ImOutis1669/Line-Following-Robot/docs/Customer_System Requirements.docx

8. Multifunctional Robot

Robotics involving design, construction, and operation of robots become more and more popular in multiple areas our life. The aim of robotics is to design machines that can assist humans. Remote control robots, robots with multiple sensors, a line following robot (use infrared sensors to follow a white line on a black surface or black line on a white surface), and many more can be implemented.

The client would like to develop multifunctional robot controlled by separately developed remote control pilot or use sensor arrays to follow the line. The pilot would use Bluetooth module and be operated by joystick. In case of line-following operation, optical sensors array needs to be integrated and capable of detecting the robot's position with respect to the line (line following robot); complete a lap of an oval line following course at Aston University.

Preferable base for this project would be DFRobot Robotics Kits - ROB0154;

https://www.mouser.co.uk/ProductDetail/DFRobot/ROB0154?qs=17u8i%2FzlE8%2FnIAY%252BNmGxXA%3D%3D

Mouser No:426-ROB0154 (final choice of this component needs to be discussed at ordering stage)

CR-101 – To develop a multifunctional robot capable of operating in 2 modes

- Line following (white or black line)
- Remote control

CR-102 – Use an optical sensor array to determine its position relative to a line and follow it

CR-103 – Capable of completing a lap non-stop of an oval track in line following mode

CR-104 – A separately developed remote control using a joystick and Bluetooth for wireless communication

CR-105 – Preferably use the DFRobot Robotics Kits - ROB0154 as a base

CR-106 – The system should be safe, reliable and easy to control for demonstration purposes

SR-201 – Use an array of infrared sensors for determining position relative to the line (CR-102)

SR 202 – Integrate a Bluetooth module for wireless communication in remote control (CR-104)

SR-203 – Use a joystick input for remote control (CR-104)

SR-204 – Use a base of the DFRobot Robotics Kits - ROB0154 (CR-105)

SR-205 – Include an emergency stop using a sensor to completely stop the vehicle (CR-106)

SR-206 – Maintain line following for a complete lap of an oval test track (CR-103/CR-106)

SR-207 – Provide a mode selection interface – a switch to change between remote-control and line following (CR-101)
