ImOutis1669/Line-Following-Robot/docs/Enviromental & Safety Consideration/Environmental.docx

# Environment (Responsible Engineering)

Group 5: John Pritchard – Project Lead

Anjalie Arachchige – Administrator

Jeremy Antwi – Quality Lead

Zebedee Batchelor – Verification Lead

Adam Khan – Responsible Engineer Lead

Oluwatomisin Agbaje – Responsible Engineer Lead

## Table Of Contents

## 1. Environmental Scope and Lifecycle Framework

The multifunctional robotic platform was developed to operate in two modes: autonomous line-following via IR sensor array and manual control via Bluetooth joystick interface. The system must reliably complete a lap of an indoor oval track and include an emergency stop function to ensure safe operation.

Environmental responsibility was embedded using a lifecycle-based framework consistent with ISO 14040 Life Cycle Assessment principles [1]. Impacts were considered across:

- Design & development
- Procurement & assembly
- Operational use
- Maintenance
- End-of-life disposal

Although the system is a prototype, a cradle-to-grave perspective was adopted to ensure environmental considerations influenced real engineering decisions rather than being treated as theoretical additions.

The robot operates exclusively indoors. Therefore, environmental focus was placed on:

- Energy efficiency
- Battery safety
- Hazardous substance awareness
- Repairability and reuse
- End-of-life management

## 2. Regulatory Environmental Compliance Considerations

### 2.1 RoHS – Restriction of Hazardous Substances

RoHS aims to reduce hazardous materials (e.g., lead, cadmium, mercury, and certain flame retardants) in electronic products. While the prototype is not commercially certified, RoHS principles influenced component selection. [2]

Environmental incorporation:

- Preference for RoHS-compliant modules and components where supplier documentation was available.
- Bill of Materials (BOM) retains part numbers and datasheet references (aligned with IEC 63000 documentation practice [3]).
- Avoid unnecessary additional PCBs or duplicate electronics.

Environmental Impact Reduction:

- Reduces toxic material release risk during disposal.
- Supports safer recycling and end-of-life processing.

Environmental outcome: Reduced hazardous material burden at disposal.

### 2.2 WEEE- Electronic waste Management

The Waste Electrical and Electronic Equipment (WEEE) Directive addresses the growing environmental burden associated with electronic waste. As the robot contains electronic assemblies, wiring, and a rechargeable battery, end-of-life management represents a key environmental responsibility. [4]

Design incorporation:

- Modular construction enables straightforward disassembly.
- Battery is removable prior to disposal.
- Functional modules, including the motor driver and Bluetooth communication module, are reusable in future projects.

This aligns with circular economy principles and reduces e-waste generation.

## 3. IEC Environmental and Safety Guidance

Relevant IEC standards were reviewed to inform environmentally responsible design decisions.

### IEC 62368-1 Hazard-Based Safety Engineering [5]

Battery was treated as a high-energy source.

Implemented:

- Insulated wiring.
- Secure routing to prevent short circuits.
- Emergency stop integrated into remote system.

Demonstrated:

- Emergency stop verified under full motor load.
- No exposed live conductors during inspection.

Environmental impact: There was a reduced risk which also resulted in reduced component waste.

### IEC 61010 – Laboratory Equipment Safety [6]

Given indoor academic use:

- No exposed conductors.
- Stable mechanical mounting.
- Battery secure during motion testing.

Demonstrated during repeated lap tests without electrical or mechanical failure.

IEC 60068 – Environmental Testing Principles [7]

Prototype reliability tested under expected indoor operating conditions.

Demonstrated:

- Repeated lap runs (minimum __ runs completed).
- Thermal check of motor driver after sustained operation.
- Bluetooth link stable under motor switching conditions.

Reliability extends lifecycle and reduces premature disposal.

## 4. Quantified Environmental Performance

To ensure environmental claims are measurable. Power profiling was conducted.

### 4.1 Measured Current Draw

Mode | Current(mA) | Notes
Idle/Standby
Line-follow
Manual drive
Peak turning

### 4.2 Battery Runtime Estimate

Battery Capacity: mAh

Average Line-Follow Current: mA

Estimated Runtime:

Runtime = Capacity ÷ Average_Current

Runtime = hours

Demonstrates operational energy awareness aligned with SDG 13 climate objectives [8].

## 5.Sustainable Development Goals Alignment

SDG 12 – Responsible Consumption and Production [8]

Implemented through:

- Modular repairable design.
- Rechargeable battery.
- RoHS-conscious component selection.
- End-of-life disassembly plan.

Demonstrated via physical module replacement and battery removal test.

SDG 13 – Climate Action [8]

Implemented through:

- PID control reducing oscillatory motor energy waste.
- Speed limiting to prevent unnecessary current draw.
- Power measurement and runtime estimation.

Demonstrated through current measurement profiling.

SDG 4 – Quality Education [8]

The platform is reusable for future cohorts. Documentation and modular construction ensure continued use beyond a single demonstration cycle.

## 6. Accessibility and Human Factors

Responsible engineering extends beyond environmental compliance.

Incorporated:

- Emergency stop easily accessible on remote.
- Clear mode switching.
- Intuitive control layout.
- Audible buzzer alerts for state change.
- Robot visible and predictable in motion.

Demonstrated:

- Emergency stop reachable within ___ seconds.
- Mode switch tested successfully during demo rehearsal.
- No ambiguity in control behaviour during manual testing.

Accessibility ensures safe operation and reduces accident-related damage, indirectly reducing environmental waste.

## 7. Commercial and Scalability Considerations

Although a prototype, commercial awareness was considered.

Incorporated:

- Use of widely available standard modules.
- Avoidance of custom PCBs where unnecessary.
- Modular parts replaceable individually.

Environmental benefit: Reduced manufacturing waste and improved scalability potential.

## 8. IEEE Code of Ethics Integration [9]

Environmental responsibility aligns with IEEE ethical obligations:

- Public safety prioritized over performance.
- No exaggerated sustainability claims made.
- Environmental limitations acknowledged transparently.
- Competence demonstrated through standards research and testing.

Ethical responsibility reinforces sustainable engineering practice.

## 9. Conclusion

Environmental responsibility was not theoretical but demonstrably incorporated into the prototype via:

- Lifecycle impact assessment [1]
- RoHS traceability [2], [3]
- WEEE-aligned disassembly [4]
- IEC safety and reliability integration [5]–[7]
- Quantified energy profiling
- SDG alignment [8]
- IEEE ethical adherence [9]
- Accessibility and commercial awareness integration

All environmental considerations were both explored and incorporated into the demonstrated prototype.

## References

[1] ISO 14040, Environmental management — Life cycle assessment, 2006.
[2] Directive 2011/65/EU (RoHS), 2011.
[3] IEC 63000, Technical documentation for RoHS compliance, 2016.
[4] Directive 2012/19/EU (WEEE), 2012.
[5] IEC 62368-1, Hazard-based safety engineering, 2018.
[6] IEC 61010-1, Laboratory equipment safety, 2010.
[7] IEC 60068, Environmental testing, 2013.
[8] United Nations, Sustainable Development Goals, 2015.
[9] IEEE, IEEE Code of Ethics, 2020.
