ImOutis1669/Line-Following-Robot/docs/Enviromental & Safety Consideration/Regulatory & standards awareness.docx

Responsible Engineering Considerations – Multifunctional Robot

EE2PRJ – Engineering Team Project

Team: Group 5

Project: Multifunctional Robot

Date: 04/02/2026

Version: Final

1.Introduction

Responsible engineering principles were considered throughout the design and development of the multifunctional robot to ensure that the final prototype operates safely, ethically, and in a manner consistent with professional engineering practice. Key considerations included regulatory and safety awareness, ethical responsibility, environmental sustainability, accessibility, and commercial realism. These considerations informed both design decisions and detailed implementation choices and were supported by a formal risk assessment and testing activities.

2.Regulatory Standards and Professional Awareness

2.1 Electrical and Machinery Safety Standards

Relevant electrical and machinery safety standards were considered during the design phase to minimise foreseeable risks associated with low-voltage electronic systems and moving components. Principles from BS EN 6024-1 (Safety of Machinery – Electrical Equipment of Machines) influenced decisions regarding the use of a low-voltage DC system, appropriate insulation of wiring, and structured cable management to reduce the likelihood of short circuits and electrical faults. The physical placement of the motor driver away from the battery, alongside provision for ventilation, was informed by these safety considerations to reduce thermal risk during operation.

Identifying risks and reducing them were further guided by ISO 12100 (Safety of Machinery-Risk Assessment and Risk Reduction) principles. This approach supported by the systematic identification of technical hazards such as battery short circuits, motor driver thermal build up and potential loss of control. As a result, key safety features were incorporated into the design, including software implemented speed limits in autonomous mode and automatic fail-safe behaviour triggered by Bluetooth communication loss.

2.2 Wireless Communication Standards

Awareness of Bluetooth SIG standards informed the selection and implementation of the Bluetooth communication module used for manual control. Consideration of interoperability and communication reliability ensured predictable system behaviour and reduced the likelihood of unsafe operation due to unexpected signal behaviour. This supported reliable manual control during testing and demonstration while maintaining safe system operation.

2.3 Professional Codes of Practice

Professional conduct throughout the project was guided by the IET Code of Conduct, which emphasises competence, safety and ethical responsibility in engineering. This influenced the team's approach to design decision making, documentation quality and verification activities. Engineering decisions were made within the technical competence of the team including realistic operational limits applied to ensure safe and reliable system behaviour.

3. Safety, Risk and Ethical Engineering

3.1 Risk Based Design Decisions

A formal health and safety risk assessment was conducted to identify potential hazards associated with electrical systems, battery operation, mechanical movement and wireless communication. Identified risks were evaluated and mitigated through the design controls such as current limited motor drivers, fail safe motor shutdown behaviour, speed restrictions and controlled charging procedures. Residual risks were reduced to acceptable levels through a combination of hardware layout decisions and software-based safeguards.

3.2 Ethical Considerations in Design

Ethical engineering considerations focused on preventing foreseeable harm and misuse of the system. the inclusion of a failsafe behaviour on Bluetooth disconnection ensured that loss of manual control would not result in uncontrolled motion. Software based operational limits were implemented to prioritise user safety over performance, demonstrating an ethical approach to balancing functionality and risk. The prototype’s capabilities and limitations were defined realistically to avoid unsafe operating assumptions.

4.Enviromental and Sustainability Considerations

Environmental responsibility as considered though component selection and system architecture. RoHS compliant components were selected to minimise the use of hazardous substances and support responsible electronic design. The use of rechargeable lithium-ion batteries reduced reliance on disposable cells, lowering environmental impact. A modular design approach was used allowing individual components to be replaced or upgraded without discarding the entire system, improving long term sustainability and reparability.

5. Inclusivity and Accessibility

Accessibility considerations were addressed by implementing a simple and intuitive control approach, enabiling users with limited prior experience to operate the system safely. Clear control inputs, predictable system responses and software-based constraints were used to reduce the likelihood of user error. These measures supported safe operation by a broad range of users during testing and demonstration.

6. Commercial and Real-World Considerations

Commercial awareness informed the selection of readily available off the shelf components to minimise cost and improve accessibility. While the prototype demonstrates core functionality, limitations associated with durability, enclosure protection and long-term reliability were acknowledged. Further development would be required to transition the system from a functional prototype to a commercially viable product, including additional testing, ruggedisation and compliance verification.

7. Summary

Responsible engineering considerations influenced key aspects of the multifunctional robot’s design and implementation. Regulatory awareness, ethical risk-based design, environmental sustainability, accessibility and commercial realism were incorporated through practical engineering decisions supported by formal documentation and testing. This approach ensured that the final prototype demonstrated not only functional performance but also alignment with professional engineering practice.
