ImOutis1669/Line-Following-Robot/docs/Enviromental & Safety Consideration/Resposible Engineering Conditions.docx

Responsible Engineering Conditions

Ethical and Societal Considerations

Within our design it was our responsibility to ensure the systems we designed operated safely and minimised harm to the user and society. The multifunctional robot designed in the project was designed with safety, reliability and responsible use in mind and not intended to be adapted for malicious intentions that may affect society.

One of the main ethical considerations of the project was user safety and prevention of unintended behaviour. The multifunctional robot uses both Bluetooth communication and motor control so the loss of signal could cause uncontrolled movement. To mitigate the risk, we implemented a fail-safe within the software which automatically stops the motors if the signal is lost. Reducing the risk of injury or damage.

Another factor was to ensure safe interaction with the users. The robot has been limited to a certain speed and has controlled motor outputs to prevent any sudden acceleration. Also, the chassis was designed to not have any sharp edges and any exposed electrical connections so the risk of the user cutting themselves or any electrical hazards during the testing of handling of the final prototype.

From a societal perspective robotics should be used to help assist education and technological development rather than be used to create risk or be misused. The multifunctional robot was designed to be used as an educational prototype, showing sensing, control systems and remote operations, which supports learning within robotics and embedded systems while ensuring the robot operates within a safe and controlled environment.

These considerations align with the professional engineering standards outlined by organisations like the Institution of Engineering and Technology (IET), which emphasises the safety, protection and responsibility of the public in engineering practice.

As much as we tried to mitigate this other people could manipulate the robot or its code to be used for malicious intentions like within the military it could be used as a remote controlled bomb which can both be used with the line following technology or operated remotely which was never its main intention as it was never designed to cause any harm but it can be manipulated to others intentions to bring harm.

Regulatory Considerations

Engineering systems must comply with the correct safety and electrical regulations to ensure safe operation. Although the multifunctional robot was developed as a prototype its design takes into consideration principles from recognised standards.

The electrical system uses a low voltage DC power supply to help reduce the risk of electrical shocks and this aligns with the safety principles like BS EN 60204-1 which is safety of machinery specifically electrical equipment of machines. The components selected for the project were selected to operate within their rated volage and current limits to prevent any electrical failure or overheating.

Proper wiring and polarity protection was put in place so that the risk of short circuiting the circuit was lowered. The motor drivers were chosen to current ratings and placed with enough space around them to allow ventilation and prevent any thermal build up whilst the multfunctional robot is operating.

The robot was designed with considerations of electromagnetic compatibility nd component safety by using certified microcontrollers and modules. Ensuring that if the system were developed more into a commercial product, it would be tested for compliance with CE marking requirements and relevant electrical safety standards and components staying RoHS compliant.

Environmental and Sustainability Considerations

Environmental responsibility is important especially in modern engineering designs. The multifunctional robot was designed with sustainability considerations for components selected, power usage and it being reusable.

The system uses a rechargeable battery source by using lithium-ion batteries this reduces waste compared to using disposable batteries supporting more sustainable operation. Rechargeable batteries allow the multifunctional robot t to be reused multiple times without generating unnecessary waste.

The design also follows a modular architecture which means key components like the microcontroller, IR sensors and motor drivers would be easily replaced or even reused for future projects. This reduces material waste and supports reparability instead of having to discard the whole system if a component failed.

Energy consumption was also considered meaning the prototype only operates when the power is switched on and the commands are received. It does not run the motors continuously; this reduces unnecessary power usage. these measures overall contribute to more environmentally responsible design practices.

Accessibility Considerations

Accessibility ensures that the robot can be used by a wide range of users despite their technical ability or physical limitations.

The multifunctional robot uses a Bluetooth control interface with a joystick style input, which provides an intuituve method of controlling the robot. This reduces the complexity of operation allowing users without advanced technical knowledge to operate the system.

The system was also designed so that the controls are easily mapped and responsive, meaning users can easily understand how movement commands affect the robot. This improves useability and reduces the likelihood of operational errors.

The autonomous line following feature reduces the need of constant manual input allowing users who aren't able to use the robot manually to set it up to be used autonomously whilst still demonstrating the main features.

Future development for accessibility would be introducing a mobile app interface or simplified graphical controls allowing users with different abilities to interact with the robot more easily.

Commercial Considerations

When designing the system, it was important to consider if the product could be developed into a commercially viable solution.

The robot was designed using low cost and widely available components, like standard microcontrollers, motor drivers and sensors. This helps in keeping the overall costs low whilst ensuring that functionality is maintained.

A major strength of the robot is it includes both Bluetooth and autonomous features improving its commercial potential as it can operate in more than one mode depending on the application. In education it can be used as a platform for teaching for remote control or embedded systems. In more practical settings the line following feature can be adapted to be used for simple route-based tasks like warehouse guidance or path tracking along routes.

The modular structure of the robot helps support scalability and future upgrades. For example, additional sensors could be added, or more advanced autonomous behaviour could be added in future versions. By combining affordability, modularity and autonomous operation the prototype demonstrates features expected from an entry level robotic platform.

Summary

Overall, the considerations were not only taken in theory but applied during the practical design of the robot. Ethical safety, regulatory awareness, sustainability, accessibility and commercial viability all influenced the way the prototype was built and operated. This demonstrates that the project reflects the responsibilities of engineers when developing products for real users and real-world applications.
