ImOutis1669/Line-Following-Robot/docs/Flowcharts/Logic Flowcharts.pptx

Line Following

Read IR sensors

Emergency Stop

Is object obstructing?

Beep depending on closeness

* Interrupt needed for this for maximum safety.

No

Is white line detected?

Adjust Car

Yes

No

Yes

Stop

Accelerate

Is car in automatic mode?

Accelerate

No

Is joystick forward?

Accelerate based on tilt

No

Yes

Yes

Operating Mode

Read Switch

Is switch high?

Manual Operation

No

Automatic Operation

Yes
