ImOutis1669/Line-Following-Robot/docs/Flowcharts/BT Transmit ISR.png

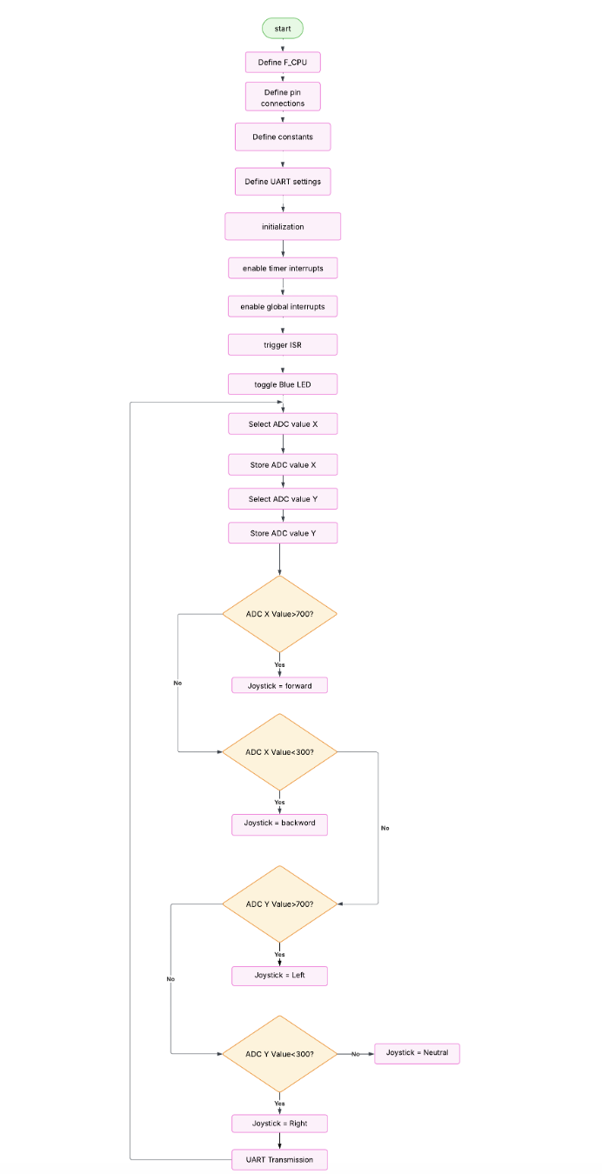
docs/Flowcharts/BT Transmit ISR.png
