ImOutis1669/Line-Following-Robot/docs/Flowcharts/Full Line Following.png

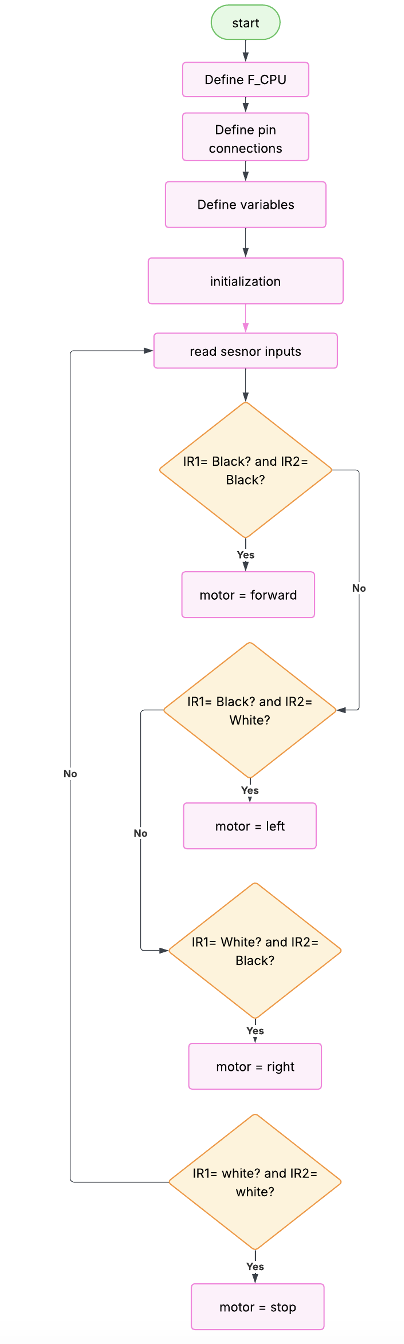
docs/Flowcharts/Full Line Following.png
