ImOutis1669/Line-Following-Robot/docs/Flowcharts/Joystick.png

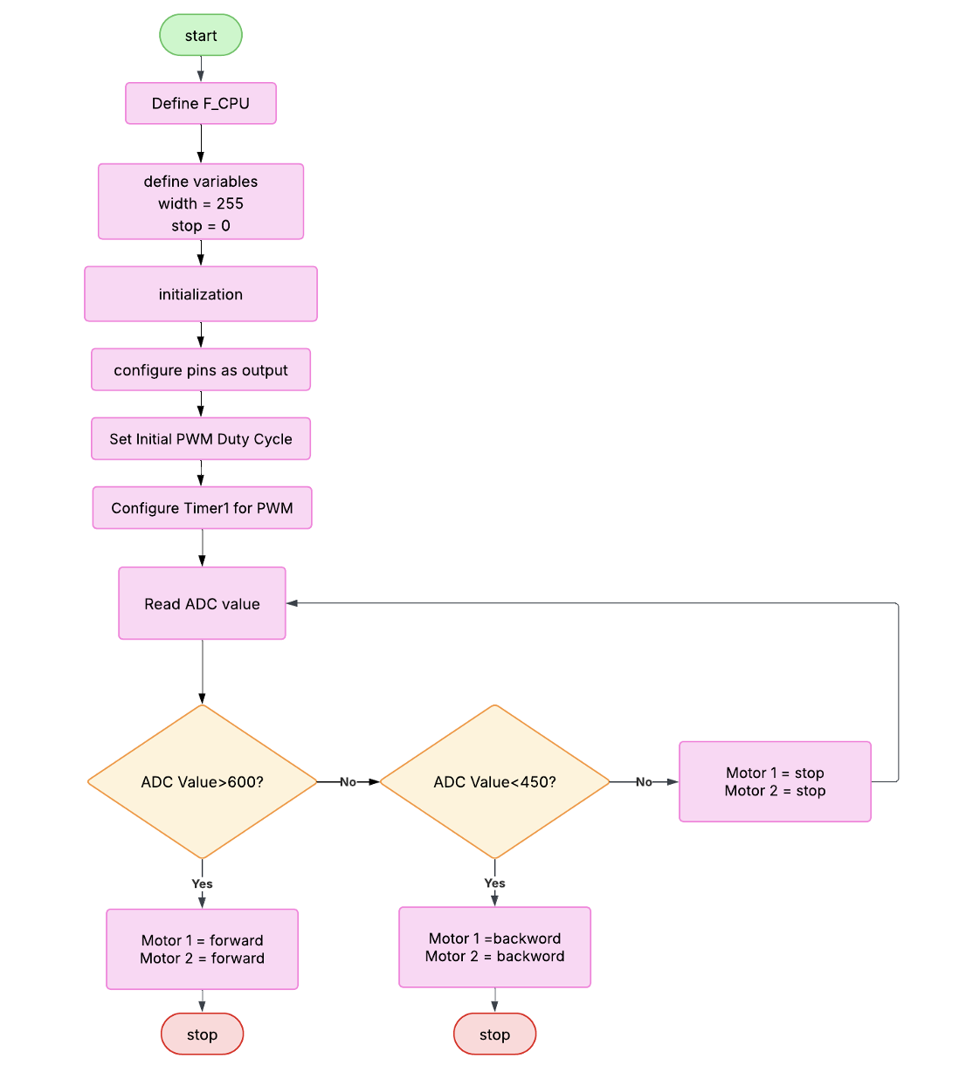
docs/Flowcharts/Joystick.png
