ImOutis1669/Line-Following-Robot/docs/Flowcharts/Ultrasonic sensor.png

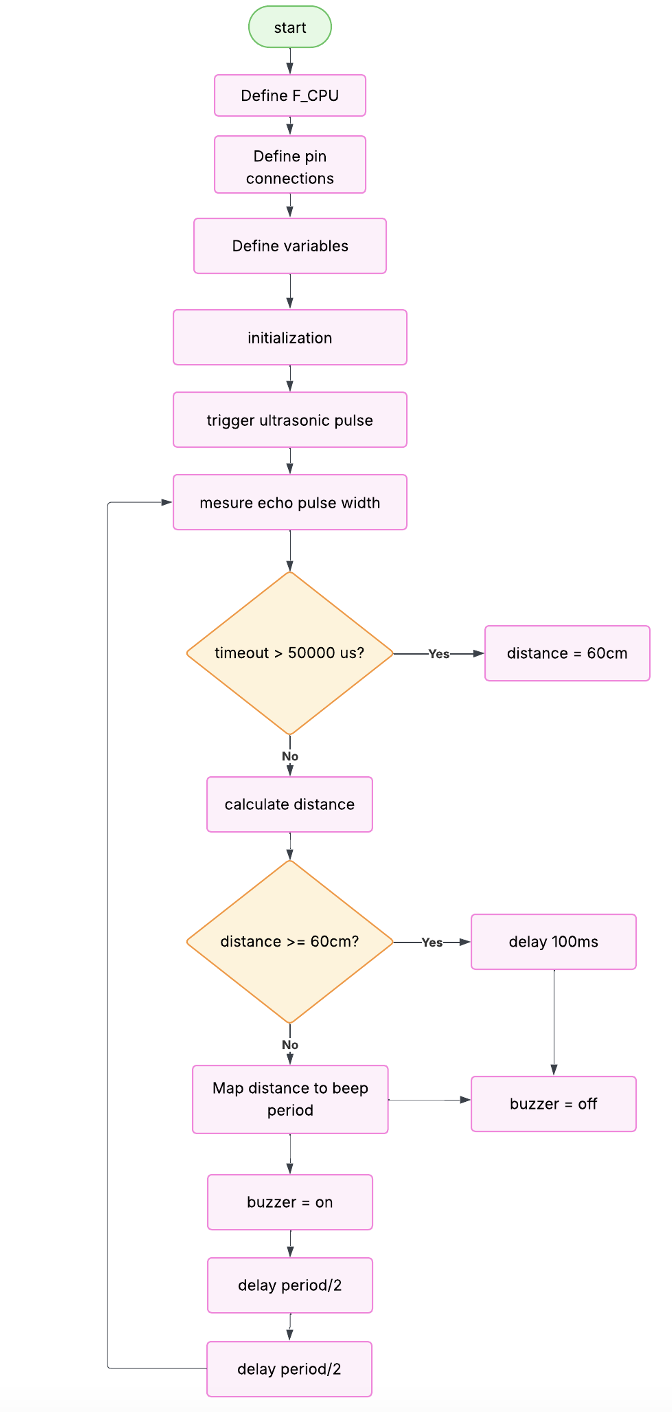
docs/Flowcharts/Ultrasonic sensor.png
