ImOutis1669/Line-Following-Robot/docs/Parts and Initial Research/Key components.docx

Key Components | Justification
DFRobot Robotics Kits - ROB0154
Infrared sensor | Detects differences in surface reflectivity, allowing the robot to identify a black line on a white surface or vice versa. This makes IR sensors essential for implementing the line-following mode, enabling the robot to track its position relative to the course and adjust steering accordingly.
Ultrasonic sensor | This measures distance to objects using sound waves, it can detect and avoid obstacles during autonomous operation, increasing safety and enabling the robot to operate in more dynamic environments. It prevents collisions during both remote and sensor-driven navigation.
Remote control -Joystick - Bluetooth module | A remote-control system allows manual operation of the robot when not in autonomous mode. It enables real-time control, making the robot multifunctional (manual + automatic modes).
Buzzer/ alarm | It can alert the operator to obstacles; this improves user interaction and enhances safety.
AVR board- ATmega 164P | The ATmega164P is the central controller of the robot. It processes sensor data, makes control decisions, communicates with the remote-control module, and drives motors. Its reliability, ease of programming, and sufficient I/O pins make it suitable for handling multiple sensors and actuators simultaneously.
Motor Driver Module | DC motors cannot be connected directly to the microcontroller due to high current requirements. The motor driver module acts as an interface, providing sufficient current and enabling control of motor direction and speed. It is essential for driving the robot’s wheels and executing line-following maneuvers.
Servo motor | A servo motor provides precise angular movement, which is useful for tasks such as turning sensors. Servos allow controlled mechanical movement based on the robot’s programmed instructions.
Battery pack | The battery pack supplies electrical power to the entire system, including the microcontroller, motors, and sensors. A portable, reliable power source is critical for mobility. Using a suitable voltage and capacity ensures stable operation and adequate runtime for both autonomous and remote-controlled modes.
