ImOutis1669/Line-Following-Robot/docs/Parts and Initial Research/Parts list.docx

Parts list:

DC Motor Driver, TB6612FNG, 2.7 V to 5.5 V

https://onecall.farnell.com/dfrobot/dri0044/dc-motor-driver-2-7v-to-5-5v-2ch/dp/3974106

DFRobot IR sensor

https://onecall.farnell.com/dfrobot/sen0017/digital-line-tracking-sensor-arduino/dp/2946112

Bluetooth module

https://cpc.farnell.com/whadda/wpi302/bluetooth-hc-05-transmission-module/dp/SC19520

Joystick

https://uk.farnell.com/dfrobot/dfr0061/joystick-module-v2/dp/2946102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

Ultrasonic sensor

https://uk.farnell.com/dfrobot/sen0001/capteur-ultrasonic-arduino-raspberry/dp/3517887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|pcrid|745506378944|kword|sen0001|match|p|plid||slid||product||pgrid|181546327327|ptaid|kwd-327353567659|&gad_source=1&gad_campaignid=22433513266&gbraid=0AAAAAD8yeHklUH8Q6X7Kt0BnKNCM8ICyw&gclid=CjwKCAiAj8LLBhAkEiwAJjbY77CNkPxSFiytESKiMM96EdfOIcLkA3MLafz116vwrXKUEXoexz59HhoCXjkQAvD_BwE

Buzzer

https://onecall.farnell.com/multicomp-pro/mcabi-020-rc/sounder-electro-mech-audio-12vdc/dp/2361099

Farnell: 1 x 3974106 - TB6612FNG, £3.30

- ~~IR sensor~~ ~~4~~
- ~~Ultrasonic sensor~~
- ~~Joystick~~
- ~~Bluetooth module~~
- ~~Buzzer~~
- AVR board- ATMega 164P
- ~~Motor Driver Module~~
- Servo motor
- Battery pack
