ImOutis1669/Line-Following-Robot/docs/Test Documents/01_Testing tables.docx

Test Reference | Test type | System Requirement (SR) | Test scope | Information | Date | Outcome
T-101/A | Unit | SR-201 | IR Sensors | Use 1 IR Sensor, connect to 2 LEDs. Move sensor over black, red LED should be on. Move over white, green LED should be on | 11/2/26 | Fail – Loose connections See test document (T-101 (https://liveastonac-my.sharepoint.com/personal/230090767_aston_ac_uk/Documents/EE2PRJ%20-%20Team%205/5)%20Quality%20and%20Verification/Hardware%20Testing/Test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))
T-101/B | Unit | SR-201 | IR Sensors | Changed wires and ensured secure connections | 11/2/26 | Fail – Short circuit
T-101/C | Unit | SR-201 | IR Sensors | Ensure correct and secure connections | 11/2/26 | Pass
T-101/D | Unit | SR-201 | IR Sensors | Test all IR sensors to check they function correctly. Identify 2 working correctly for use in the design | 18/2/26 | Fail – 3/4 IR sensors not functioning.
T-101/E | Unit | SR-201 | IR Sensors | Test grove IR sensors as a temporary replacement for non-functional DFRobot sensors | 18/2/26 | Pass
T-102/A | Unit | SR-201 | IR Sensors | Use 2 IR sensors, turn on red and yellow LED when black, turn on green and blue LED when white | 11/2/26 | Fail – See testing document (T-102 (https://liveastonac-my.sharepoint.com/personal/230090767_aston_ac_uk/Documents/EE2PRJ%20-%20Team%205/5)%20Quality%20and%20Verification/Hardware%20Testing/Test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)), revert to T-101
T-102/B | Unit | SR-201 | IR Sensors | Test 2 grove IR sensors to control 4 LEDs | 18/2/26 | Fail – logic inverted
T-102/C | Unit | SR-201 | IR Sensors | Invert logic in code then test controlling 4 LEDs | 18/2/26 | Pass
T-102/D | Unit | SR-201 | IR Sensors | Revert to using 2 DFRobot IR sensors to control 4 LEDs | 25/2/26 | Pass
T-102/E | Unit | SR-201 | IR Sensors | Change logic of IF to make the outcome dependent on the combination of sensor 1 and 2 | 25/2/26 | Fail – Yellow LED stayed permanently on
T-102/F | Unit | SR-201 | IR Sensors | Change the logic of the else to turn off all LEDs except Red when both detect white | 25/2/26 | Pass
T-103 | Unit/ performance | SR-201 | IR Sensors | Suspend the IR Sensors at 1cm | 25/2/26 | Pass
T-104 | Unit/ performance | SR-201 | IR Sensors | Suspend the IR Sensors at 2cm from surface | 25/2/26 | Pass
T-105/A | Unit/ performance | SR-201 | IR Sensors | Suspend the IR Sensors at 3cm from surface | 25/2/26 | Fail (See – T-105 (https://liveastonac-my.sharepoint.com/personal/230090767_aston_ac_uk/Documents/EE2PRJ%20-%20Team%205/5)%20Quality%20and%20Verification/Hardware%20Testing/Test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))
T-105/B | Unit/ performance | SR-201 | IR Sensors | Suspend IR sensors at 2.5cm | 25/2/26 | Fail
T-105/C | Unit/ performance | SR-201 | IR Sensors | Suspend IR sensors at 2.2cm | 25/2/26 | Fail
T-105/D | Unit/ performance | SR-201 | IR Sensors | Suspend IR Sensors at 2.1cm | 25/2/26 | Fail
T-106A | Unit | SR-204 | Single motor control | Spin 1 motor clockwise for set time then anticlockwise. | 18/2/26 | Fail – see test document (T-106 (https://liveastonac-my.sharepoint.com/personal/230090767_aston_ac_uk/Documents/EE2PRJ%20-%20Team%205/5)%20Quality%20and%20Verification/Hardware%20Testing/Test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))
T-106B | Unit | SR-204 | Single motor control | Spin 1 motor clockwise for set time then anticlockwise. | 18/2/26 | Pass
T-107 | Unit | SR-204 | Dual motor control | Spin both motors clockwise for set time then anticlockwise | 18/2/26 | Pass
T-108 | Unit | SR-204 | Dual motor control | Spin motors in opposite directions to move robot forwards | 18/2/26 | Pass
T-109 | Unit | SR-203 | Joystick | Characterise joystick – Read ADC values relating to x-axis | 11/2/26 | Pass
T-110 | Unit | SR-203 | Joystick | Characterise joystick – Read ADC values relating to y-axis | 11/2/26 | Pass
T-111 | Unit | SR-203 | Joystick | Using only the y-axis of the joystick, light a green LED for pushing forwards and a Red LED for backwards | 11/2/26 | Pass
T-112 | Unit | SR-203 | Joystick | Using only the y-axis of the joystick, light a Blue LED for pushing left and a Yellow LED for right | 11/2/26 | Pass
T-113/A | Unit | SR-203 | Joystick | Use both x and y axis, move joystick in all 4 directions, lighting red, blue, green, yellow LEDs | 11/2/26 | Fail (see T-113 (https://liveastonac-my.sharepoint.com/personal/230090767_aston_ac_uk/Documents/EE2PRJ%20-%20Team%205/5)%20Quality%20and%20Verification/Hardware%20Testing/Test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))
T-113/B | Unit | SR-203 | Joystick | Change admux data bits using function in the code to select ADC input | 11/2/26 | Pass
T-114/A | Unit | SR-202 | Bluetooth | Connect BT module to a laptop or phone, turn an LED on/ off | 18/2/26 | Fail (see T-114 (https://liveastonac-my.sharepoint.com/personal/230090767_aston_ac_uk/Documents/EE2PRJ%20-%20Team%205/5)%20Quality%20and%20Verification/Hardware%20Testing/Test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))
T-114/B | Unit | SR-202 | Bluetooth | Connect BT module to a laptop or phone, turn an LED on/ off | 25/2/26 | Fail
T-114/C | Unit | SR-202 | Bluetooth | Connect BT module to a laptop or phone, turn an LED on/ off | 25/2/26 | Pass
T-115/A | Unit | SR-202 | Bluetooth | Put HC-05 slave into AT-Mode and communicate over serial. Send commands to enter slave mode. ‘AT+ROLE=0’ | 25/2/26 | Fail (see T-115 (https://liveastonac-my.sharepoint.com/personal/230090767_aston_ac_uk/Documents/EE2PRJ%20-%20Team%205/5)%20Quality%20and%20Verification/Hardware%20Testing/Test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))
T-115/B | Unit | SR-202 | Bluetooth | Follow correct powerup procedure with the slave, enter AT-Mode | 25/2/26 | Pass
T-116 | Unit | SR-202 | Bluetooth | In AT-Mode, find the address for the slave using the command AT+ADDR? | 25/2/26 | Pass Address = 98d3:91:febfe4
T-117 | Unit | SR-202 | Bluetooth | Enter AT-Mode with the master HC-05 following correct start-up procedure | 25/2/26 | Pass
T-118 | Unit | SR-202 | Bluetooth | Using ‘AT+CMODE=0’ set the HC-05 to master mode connecting to only 1 device, should respond with ‘OK’ | 25/2/26 | Pass
T-119 | Unit | SR-202 | Bluetooth | Using ‘AT+BIND=98d3:91:febfe4’ set the HC-05 to only connect to the device with that address (the slave HC-05). Should respond with ‘OK’ | 25/2/26 | Pass
T-120/A | Unit | SR-202 | Bluetooth | Send and receive commands between 2 modules – Light LEDs controlled by Slave using signal from Master, light 4 LEDs in a pre determined pattern | 4/3/26 | Fail (see T-120)
T-120/B | Unit | SR-202 | Bluetooth | Reconnect power in correct way (remove 3v3 connection from KEY) | 4/3/26 | Pass
T-121 | Unit | SR-202 | Bluetooth | Read joystick values, transmit a character via Bluetooth to control 4 LEDs (signifying direction) | 4/3/26 | Pass
T-122 | Subsystem | SR-203 | Manual control subsystem | Read joystick values, transmit a character via Bluetooth to the 4 direction combinations for the motors | 3/3/26 | Fail- gets latched into a direction, move to T-123
T-123/A | Subsystem | SR-203 | Manual control subsystem | Add LEDs to check directions are being received correctly | 3/3/26 | Fail (see T-123)
T-123/B | Subsystem | SR-203 | Manual control subsystem | Connect a terminal to check the serial response to commands being sent | 3/3/26 | Fail
T-123/C | Subsystem | SR-203 | Manual control | Connect the motor driver to a separate power supply | 11/3/26 | Pass
T-124 | Unit | SR-202 | Bluetooth | Enter AT mode with new HC05 slave | 11/3/26 | Pass
T-125 | Unit | SR-202 | Bluetooth | Put HC-05 into slave mode using ‘AT+ROLE=0’ | 11/3/26 | Pass
T-126 | Unit | SR-202 | Bluetooth | Read HC-05 Address using ‘AT+ADDR?’ | 11/3/26 | Pass: address = 98D3:21:F8547E
T-127 | Unit | SR-202 | Bluetooth | Enter AT-Mode with the master HC-05 following correct start-up procedure | 11/3/26 | Pass
T-128 | Unit | SR-202 | Bluetooth | Using ‘AT+CMODE=0’ set the HC-05 to master mode connecting to only 1 device, should respond with ‘OK’ | 11/3/26 | Pass
T-129 | Unit | SR-202 | Bluetooth | Using ‘98D3:21:F8547E’ set the HC-05 to only connect to the device with that address (the slave HC-05). Should respond with ‘OK’ | 11/3/26 | Pass
T-130 | Subsystem | SR-201 | Line following subsystem | Set the robot to follow a straight-line track | 11/3/26 | Pass
T-131 | Subsystem | SR-201 | Line following | Add a curved track section, set robot to follow | 11/3/26 | Pass
T-132/A | Subsystem | SR-201 | Line following | Add a section with a stop line. Robot should stop when both IR sensors see white | 11/3/26 | Fail – continued along the track no pause
T-132/B | Subsystem | SR-201 | Line following | Edit code, no longer set default pulse width in While | 11/3/26 | Pass
T-133/A | Subsystem | SR-201 | Line following | Set IR Sensors in closest hole | 16/3/26 | Fail (see T-133 (https://liveastonac-my.sharepoint.com/personal/230090767_aston_ac_uk/Documents/EE2PRJ%20-%20Team%205/5)%20Quality%20and%20Verification/Hardware%20Testing/Test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))
T-133/B | Subsystem | SR-201 | Line following | Move IR sensors to hole 2 | 16/3/26 | Fail
T-133/C | Subsystem | SR-201 | Line following | Move IR sensors to hole 3 | 16/3/26 | Pass
T-133/D | Subsystem | SR-201 | Line following | Move IR sensors to hole 4 | 16/3/26 | Pass
T-133/E | Subsystem | SR-201 | Line following | Move IR sensors to hole 5 | 16/3/26 | Pass
T-133/F | Subsystem | SR-201 | Line following | Move IR sensors to hole 6 | 16/3/26 | Pass
T-134/A | Subsystem | SR-201 | Line following | Set PWM for speed to 200 | 17/3/26 | Pass (See T-134 (https://liveastonac-my.sharepoint.com/personal/230090767_aston_ac_uk/Documents/EE2PRJ%20-%20Team%205/5)%20Quality%20and%20Verification/Hardware%20Testing/Test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))
T-134/B | Subsystem | SR-201 | Line following | Set PWM for speed to 210 | 17/3/26 | Pass
T-134/C | Subsystem | SR-201 | Line following | Set PWM for speed to 220 | 17/3/26 | Pass
T-134/D | Subsystem | SR-201 | Line following | Set PWM for speed to 230 | 17/3/26 | Pass
T-134/E | Subsystem | SR-201 | Line following | Set PWM for speed to 240 | 17/3/26 | Fail
T-134/F | Subsystem | SR-201 | Line following | Set PWM for speed to 235 | 17/3/26 | Pass
T-135/A | Subsystem | SR-203 | Manual control | Transmit characters using joystick ADC values. F, B, L, R, s | 18/3/26 | Fail (see T-135 (https://liveastonac-my.sharepoint.com/personal/230090767_aston_ac_uk/Documents/EE2PRJ%20-%20Team%205/5)%20Quality%20and%20Verification/Hardware%20Testing/Test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))
T-135/B | Subsystem | SR-203 | Manual control | Connect serial to master. Check that transmission code is running correctly. | 18/3/26 | Pass
T-135/C | Subsystem | SR-203 | Manual control | Connect serial to slave, send characters to check code receives correctly | 18/3/26 | Pass
T-136 | Unit | SR-205 | Buzzer | Power the buzzer, a tone should sound | 4/3/26 | Pass
T-137 | Unit | SR-205 | Buzzer | Turn the buzzer on for 500ms then off for 500ms | 4/3/26 | Pass
T-138 | Unit | SR-205 | Ultrasonic sensor | Connect to oscilloscope and check that the closer an object is, the greater the magnitude of the sensors analogue output (proportionally) | 4/3/26 | Pass
T-139 | Unit | SR-205 | Ultrasonic sensor | Connect ultrasonic and an LED, change the brightness of the LED depending on the distance from the object | 4/3/26 | Pass
T-140/A | Subsystem | SR-205 | Emergency alert | Connect ultrasonic and the buzzer, as the object gets closer, the buzzer should beep louder | 4/3/26 | Fail (See T-140 (https://liveastonac-my.sharepoint.com/personal/230090767_aston_ac_uk/Documents/EE2PRJ%20-%20Team%205/5)%20Quality%20and%20Verification/Hardware%20Testing/Test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))
T-140/B | Subsystem | SR-205 | Emergency alert | Alter code to increase the frequency buzzer beeps at depending on the distance (Closer = more frequent beeps) | 4/3/26 | Pass
T-140/C | Subsystem | SR-205 | Emergency alert | Decrease the distance vs frequency, allow objects to be closer before the | 4/3/26 | Pass
T-141 | Subsystem | SR-203 | Manual control | Using the new HC-05 modules (See T-124) read joystick values on controller, control 4 LEDs symbolising direction | 18/3/26 | Pass
T-142 | Subsystem | SR-203 | Manual control | Use joystick values to control direction of motors forwards/ backwards | 18/3/26 | Pass
T-143/A | Subsystem | SR-203 | Manual control | Use joystick to move forwards, backwards, left, right | 18/3/26 | Fail (see T-143 (https://liveastonac-my.sharepoint.com/personal/230090767_aston_ac_uk/Documents/EE2PRJ%20-%20Team%205/5)%20Quality%20and%20Verification/Hardware%20Testing/Test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))
T-143/B | Subsystem | SR-203 | Manual control | Change PWM width loading to stop when joystick is centred | 18/3/26 | Pass
T-144 | Subsystem | SR-207 | Mode switching | Implement the joystick button as the mode switching toggle. Every time it is pressed, the mode should change. Use 2 LEDs to signify the 2 separate modes. | 19/3/26 | Pass
T-145 | System | | Full system | Swap between line following and manual control mode. Default should be manual control and no movement unless joystick is moved or mode switched to line following | 19/3/26 | Pass
T-146/A | Compatibility | | Full system | Try robot on carpet | 19/3/26 | Pass
T-146/B | Compatibility | | Full system | Try robot on hard floor | 19/3/26 | Pass
T-147 | Performance | SR-201 | Line following | Change track shape from oval to more complicated layout, test if the robot can follow it | 20/3/26
T-148 | Usability | | Full system | Give control of the robot to a user with no prior experience, explain the basics of using it and understand where it could be improved | 23/3/26
T-149 | Subsystem | SR-205 | Emergency alert | Place on object on the track during line following, robot should stop and buzzer should beep | 23/3/26
