ImOutis1669/Line-Following-Robot/docs/Test Documents/T-101.docx

# T-101:

This test uses 1 IR sensor to light a red/ green LED depending on whether it detects red or green. This uses the test code “IR Sensor Polling.c (https://liveastonac-my.sharepoint.com/personal/230090767_aston_ac_uk/Documents/EE2PRJ%20-%20Team%205/3)%20Software/Multifunctional%20robot/IR%20Sensor%20Polli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)”

## Expected outcome:

When IR_1 sensor detects black, the Red LED is on and Green LED is off. When the sensor detects white, the Red LED is off and the Green LED is on.

## T-101/A – 11/2/26

Result – Fail

### Details:

This failure was caused by loose connections to the IR sensor, the male-male wires used to connect the sensor cable to the board were not securely connected.

### Actions:

Check all connections are secure, switch to better fitting wires before testing again

## T-101/B – 11/2/26

Result – Fail

### Details

Failure due to a short circuit. Ground and power lines on the breadboard used for the LEDs were incorrectly connected, causing a short circuit

### Actions:

Fix any short circuit issue, ensure connections are all in the right place and then test again.

## T-101/C – 11/2/26

Result – Pass

### Details:

The sensor behaved as expected, lighting the red LED when black was detected and the green LED when white was detected.

## T-101/D - 18/02/26

Result-Fail

### Details:

3/4 IR sensors do not function properly.

### Actions:

Temporarily swapped to grove IR sensors while waiting for more DFRobot sensors to arrive . Repeat tests to ensure Grove sensors are functioning properly

T-101/E – 18/02/26

Result - Fail

Details:

Failure was due to grove sensor outputs being inverted from the behaviour of the DFRobot sensors

Actions:

Alter code to expect
