ImOutis1669/Line-Following-Robot/docs/Test Documents/T-102.docx

T-102:

This test uses 2 IR sensors to light 4 LEDs, IR sensor 1 controls red and green LEDs, IR sensor 2 controls yellow and blue LEDs. Test code used was “Double IR Sensor Polling.c (https://liveastonac-my.sharepoint.com/personal/230090767_aston_ac_uk/Documents/EE2PRJ%20-%20Team%205/3)%20Software/Multifunctional%20robot/Double%20IR%20Senso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)”

## Expected outcome:

When IR_1 sensor detects black, the Red LED is on and Green LED is off. When the sensor detects white, the Red LED is off and the Green LED is on.

When IR_2 sensor detects black, the Yellow LED is on and Blue LED is off. When the sensor detects white, the Yellow LED is off and the Blue LED is on.

## T-102/A – 11/2/26

Result-Fail

### Details:

IR sensor 1 performed as expected, lighting the red LED when black was detected and the green when white was. IR sensor 2 did not perform as expected, the yellow LED was permanently on. Swapping the two IR sensors connections led to similar results but the other way round: Red LED permanently on, yellow and blue LEDs swapping as expected. This shows a hardware issue with one of the sensors not performing as expected.

### Actions:

Revert back to T-101 and test that IR sensors work correctly. Ensure that 2 sensors are fully functioning for use in the project. Temporarily use Grove IR Sensors while DFRobot are on order

## T-102/B – 18/2/26

Result – Fail

### Details:

Used Grove IR Sensors while waiting for new DFRobot ones, logic for Grove sensors is inverted compared to DFRobot so while the sensors worked properly, logic was flipped.

### Actions:

Flip logic temporarily to work with Grove sensors

## T-102/C – 18/2/26

Result – Pass

### Details:

Behaved as expected, using Grove sensors as temporary replacements

## T-102/D – 25/2/26

Result – Pass

### Details:

Using DFRobot IR sensors, behaved as expected.

### Actions:

Change IF statement logic in code to alter the behaviour. Both sensors should be checked to determine the outcome rather than using one sensor for 2 LEDs and the other for 2 LEDs. E.g. IF Sensor_1 and Sensor_2 both detect black, green (forwards is on).

## T-102/E – 25/2/26

Result – Fail

### Details:

IF statement changed to determine outcome based on both sensors not just one sensor controlling 2 LEDs. Yellow LED stayed permanently on.

### Actions:

Edit the IF/Else, clearing the Yellow LED correctly depending on IR sensor reading

## T-102/F – 25/2/26

Result – Pass

### Details:

Performed as expected
