ImOutis1669/Line-Following-Robot/docs/Test Documents/T-105.docx

# T-105

This test was carried out to determine the best height for using the IR sensors at.

Expected outcome:

When the IR sensors detect the white surface, the LED on them should turn on.

## T-105/A - 25/2/26

Result – Pass

### Details:

IR sensors suspended at 1cm from white surface, detected

### Actions:

Increase height to 2cm

## T-105/B - 25/2/26

Result – Pass

### Details:

IR sensors suspended at 2cm from white surface, detected

### Actions:

Increase height to 3cm

## T-105/C - 25/2/26

Result – Fail

### Details:

IR sensors suspended at 3cm from white surface, didn’t detect

### Actions:

Decrease height to 2.5cm

## T-105/D - 25/2/26

Result – Fail

### Details:

IR sensors suspended at 2.5cm from white surface, didn’t detect

### Actions:

Decrease height to 2.2cm

## T-105/E - 25/2/26

Result – Fail

### Details:

IR sensors suspended at 2.2cm from white surface, didn’t detect

### Actions:

Decrease height to 2.1cm

## T-105/F - 25/2/26

Result – Fail

### Details:

IR sensors suspended at 2.1cm from white surface, didn’t detect

### Actions:

Use IR sensors at maximum height of 2cm from the surface
