ImOutis1669/Line-Following-Robot/docs/Test Documents/T-106.docx

# T-106

This test was done to ensure motor control logic was correct

## Expected outcome:

Motor should spin clockwise for 500ms then anticlockwise for 500ms

## T-106/A – 18/2/26

Result – Fail

### Detail:

Motor span anticlockwise when it should have been clockwise

### Action:

Invert control logic to get correct direction

## T-106/B – 18/2/26

Result – Pass

### Detail:

Performed as expected
