ImOutis1669/Line-Following-Robot/docs/Test Documents/T-113.docx

# T-113

This test is of the Joystick, controlling 4 LEDs

## Expected outcome:

The x and y axis should be read and used to turn 4 LEDs on and off, signifying forwards, backwards, left, and right.

## T-113/A – 11/2/26

Result – Fail

### Detail:

Only x values were being read, only the yellow and blue LEDs (Left and right) were being toggled

### Action:

Add a function to change ADMUX bits, changing ADC input

## T-113/B – 11/2/26

Result – Pass

### Detail:

Functions correctly switched between x and y inputs
