ImOutis1669/Line-Following-Robot/docs/Test Documents/T-114.docx

# T-114

Connecting 1 HC05 to a laptop, sending scharacters from the latop to turn LEDs on.

## Expected outcome:

When R/G/B/Y is sent, the corresponding LED turns on. When r/g/b/y is sent, the corresponding LED turns off

## T-114/A – 18/2/26

Result – Fail

### Detail:

Connected to laptop but connection failed as the COM port wasn’t held open

### Action

Use a terminal such as PuTTY to hold open the BT COM port

## T-114/B – 18/2/26

Result – Fail

### Detail:

Used PuTTY terminal to connect, Rx and Tx pins were connected the wrong way round

### Action

Connect Rx of HC-05 to Tx of AVR and Tx of HC-05 to Rx of AVR

## T-114/C – 18/2/26

Result – Pass

### Detail:

Behaved as expected
