ImOutis1669/Line-Following-Robot/docs/Test Documents/T-115.docx

# T-115

Enter AT mode with the HC-05

## Expected outcome:

Transmitting ‘AT’ should get the response ‘OK’

## T-115/A – 25/2/26

Result – Fail

### Detail:

Couldn’t enter AT mode, needs specific power up sequence

### Action:

Connect Rx, Tx, Gnd and KEY of HC-05, then connect VCC to enter AT Mode

## T-115/B – 25/2/26

Result – Pass

### Detail:

Entered AT mode
