ImOutis1669/Line-Following-Robot/docs/Test Documents/T-120.docx

# T-120

Send and receive between master and slave HC-05

## Expected outcome:

4 LEDs should light in a pattern

## T-120/A – 25/2/26

Result – Fail

### Detail:

Still in AT Mode

### Action:

Remove KEY connection

## T-120/B – 25/2/26

Result – Pass

### Detail:

Correctly turned LEDs on/off
