ImOutis1669/Line-Following-Robot/docs/Test Documents/T-123.docx

# T-123

Testing if directions are being received from the controller to the receiver, using LEDs and controlling motors

## Expected outcome:

Direction LEDs should light depending on joystick direction and motors should spin to move in that direction

## T-123/A – 3/3/26

Result – Fail

### Detail:

First direction is received then latches and no others are received

### Action:

Connect serial monitor to double check no other characters are received

## T-123/B – 3/3/26

Result – Fail

### Detail:

First direction is received then latches and no others are received, confirmed with serial monitor

### Action:

Connect motor driver to a separate supply to AVR board

## T-123/C– 3/3/26

Result – Pass

### Detail:

Motors move as expected, LEDs light as expected
