ImOutis1669/Line-Following-Robot/docs/Test Documents/T-132.docx

# T-132

Testing line following and stopping

## Expected outcome:

Follow track and stop at start/ finish line

## T-132/A – 11/3/26

Result – Fail

### Detail:

Robot reached start/finish line and didn’t stop, just continued following the track.

### Action:

Remove default PWM width setting from while loop

## T-132/B – 11/3/26

Result – Pass

### Detail:

Correctly stopped when start/finish line reached
