ImOutis1669/Line-Following-Robot/docs/Test Documents/T-133.docx

# T-133

Testing various sensor widths to establish the ideal setting

## Expected outcome:

Certain widths will work better than others, test all to establish ideal

## T-133/A - 16/3/26

Result – Fail

### Detail:

Sensors in hole 1, too close together, both over the line

### Action:

Move to hole 2

## T-133/B - 16/3/26

Result – Fail

### Detail:

Sensors in hole 2, too close together, both over the line

### Action:

Move to hole 3

## T-133/C -16/3/26

Result – Pass

### Detail:

Sensors in hole 3, follows line correctly

### Action:

Move to hole 4

## T-133/D -16/3/26

Result – Pass

### Detail:

Sensors in hole 4, follows line correctly smoother than hole 3

### Action:

Move to hole 5

## T-133/E -16/3/26

Result – Pass

### Detail:

Sensors in hole 5, lots of changes of direction

### Action:

Move to hole 6

## T-133/F -16/3/26

Result – Pass

### Detail:

Sensors in hole 6, lots of changes of direction

### Action:

Use hole 4 for smoothest movement
