ImOutis1669/Line-Following-Robot/docs/Test Documents/T-134.docx

# T-134

Testing various speeds to see which is best

## Expected outcome:

At acceptable speeds, the robot will follow the track correctly. When speed is too high, it will deviate from the course

## T-134/A-17/3/26

Result – Pass

### Detail:

PWM width set to 200, correctly follows the track

### Action:

Increase PWM width to 210

## T-134/B-17/3/26

Result – Pass

### Detail:

PWM width set to 210, correctly follows the track

### Action:

Increase PWM width to 220

## T-134/C-17/3/26

Result – Pass

### Detail:

PWM width set to 220, correctly follows the track

### Action:

Increase PWM width to 230

## T-134/D-17/3/26

Result – Pass

### Detail:

PWM width set to 230, correctly follows the track

### Action:

Increase PWM width to 240

## T-134/E-17/3/26

Result – Fail

### Detail:

PWM width set to 240, too fast to maintain line following

### Action:

Reduce PWM width to 235

## T-134/F-17/3/26

Result – Pass

### Detail:

PWM width set to 235, correctly follows the track.

### Action:

Take 235 as the maximum value
