ImOutis1669/Line-Following-Robot/docs/Test Documents/T-135.docx

# T-135

Testing transmission/ reception code

## Expected outcome:

Joystick values should cause characters to be sent, use serial monitor to check that both transmission and reception code works

## T-134/A – 18/3/26

Result – Fail

### Detail:

No LEDs were turned on using BT to transmit joystick direction

### Action:

Connect serial monitor to individually check transmission/ reception code. If they both work, the issue is with the HC-05

## T-134/B – 18/3/26

Result – pass

### Detail:

Test transmission code by connecting serial monitor and checking characters are sent. Characters were received as expected by laptop

### Action:

Test reception code

## T-134/C – 18/3/26

Result – pass

### Detail:

Test reception code by connecting serial monitor and sending characters to toggle LEDs. LEDs behaved as expected.

### Action:

Revert to T-124 to set up new HC-05 modules
