ImOutis1669/Line-Following-Robot/docs/Enviromental & Safety Consideration/Health and safety Risk assessment.docx

Project: Multifunctional Mobile Robot
Location: University electronics laboratory
Assessor: Adam Khan
Date: 14/01/2026

The risk assessment was conducted in alignment with the ISO 12100 risk identification and risk reduction principles. The hazards were identified through analysis of electrical, mechanical, software and operational aspects of the multifunctional mobile robot.

Severity (S) and Likelihood (L) were rated using a qualitive three level scale:

Severity (S):

- L (Low) - Minimal injury risk or minor inconvenience
- M (Medium) - Risk of minor injury or moderate equipment damage
- H (High) - Risk of serious injury, fire or major equipment damage

Likelihood (L):

- L (Low) - Unlikely during normal operation
- M (Medium) - Could occur under certain conditions
- H (High)- Likely to occur without mitigation

For documentation clarity the qualitative ratings were mapped to a numerical 0-10 internal scale to help indicate relative risk severity prior to mitigation.

For initial risk it was calculated as risk=Severity x Likelihood and if the risk scored above a 6 were considered high and required mitigation measures. Residual risk below 3 was considered acceptable for supervised laboratory demonstration.

Hazard | Who Might be Harmed | Potential Harm | Severity (S) | Likelihood(L) | Initial Risk 0(Low)-10(High) | Control Measures Implemented | Residual Risk 0(Low)-10(High) | Risk Owner | Verification of Control
Electrical Short Circuit | User | Overheating, fire risk, component damage | M | M | 5 | Low voltage DC system, insulated wiring, correct polarity | 2 | Responsible Engineer Lead | Visual inspection of wiring and polarity check prior to power up
Battery overheating | User | Burns, fire risk | H | M | 7 | Rechargeable battery used within rated limits, supervised charging, separation from heat source | 2 | Responsible Engineer Lead | Supervised charging test and thermal observation during operation
Unexpected robot movement | Users, bystanders | Collision, minor injury | M | M | 5 | Speed limits in software, controlled PID tuning, safe test area | 2 | Verification Lead | Functional testing of speed limits and the fail safe logic
Sharp chassis edges | Users | Cuts during assembly | M | L | 3 | Rounded chassis edges, deburring, careful mounting | 1 | Project Lead | Physical inspection prior to assembly
Motor driver overheating | Users, electronics | Burns, component failure | M | M | 5 | Ventilated placement, current-limited driver, thermal spacing | 2 | Responsible Engineering Lead | Temperature monitoring during extended motor operation
Trip hazards during testing | Users | Falls or minor injury | M | L | 3 | Clear testing area, cable management, supervised testing | 1 | Quality Lead | Lab inspection before the demonstration
Incorrect sensor mounting | Users, equipment | Navigation errors, collisions | M | M | 5 | Secure mounting, calibration before operation | 2 | Verification Lead | Calibration test and line follow validation
Software malfunction | Users | Unintended motion | M | M | 5 | Modular software design, independent mode testing, reset capability | 2 | Verification Lead | Independent mode testing and reset functionality validation
Loss of Bluetooth connection during motion | Users, bystanders | Uncontrolled movement or collision | S | S | 9 | Automatic fail-safe shutting the motors off | 2 | Verification Lead | Simulated Bluetooth disconnection testing

Following the implementation of mitigation measures, all the identifiable risks have been reduced to acceptable levels for a supervised indoor laboratory demonstration. There are no high residual risks remaining under the controlled testing conditions. Operation outside this environment would require reassessment and additional compliance validation.

Limitations and Further Risk Considerations

While risks have been mitigated for laboratory demonstration, further enclosure protection, extended thermal endurance testing, and former compliance verification would be required for commercial deployment or unsupervised use.
