ImOutis1669/Line-Following-Robot/docs/Project Management/Lessons learned.docx

## TABLE OF CONTENTS

## 1. Overview

This section compares the original project plan with the actual delivery of the line tracking robot. Although the group completed key stages of the project, progress was less straightforward than expected. The main differences came from platform redesign, extra PCB implementation work, and Bluetooth integration issues. These challenges affected the schedule but also provided useful lessons about planning, testing, and system integration.

## 2. Plan vs Delivery

At the planning stage, the project was expected to progress linearly. The platform was meant to be designed once, fitted securely to the tank chassis, and then used as a base to secure the rest of the hardware and software components. The PCB stage was expected to move smoothly from design to fabrication and then into assembly and testing. Communication features such as Bluetooth were also expected to function during integration with only minor adjustments.

Things did not go that smoothly. The platform needed further changes before it could be properly fastened onto the tank chassis, which meant that the original design was not fully suitable the first time. Because of this, multiple versions of the platform had to be made before one worked properly. This added extra time and effort that had not really been accounted for at the planning stage.

The assembly process also took longer than expected, as parts had to be screwed and unscrewed multiple times which might sound minor at first, but slowed the progress down a lot showing that mechanical integration is more time-consuming than it seems on paper.

The PCB side of the project also turned out to be more than just designing the boards. After the fabricated boards were collected, they still had to be soldered, tested and troubleshot, showing that even when a task looks complete in theory, more work will be required to complete it in practice.

Another issue was Bluetooth not working as expected. This created delays because communication was meant to be part of the integrated system, but instead, it became another area that needed troubleshooting. That had a knock-on effect on testing and overall integration.

Overall, the project was delivered through repeated refinement rather than through a single straightforward build process. Although this slowed progress in comparison with the original plan, it provided a more realistic understanding of how engineering systems are developed in practice.

## 3. Plan vs Delivery Table

Area | Planned | Actual Delivery | Impact on Project | Lessons Learned
Platform Design | One platform will be designed | Multiple adjustments and multiple platform versions were needed | Extra time spent on redesign and refitting | Platform dimensions and mounting compatibility should be checked earlier
Mechanical Assembly | Components would be mounted with minimal changes | Repeated screwing and unscrewing were required during assembly | Slower assembly and reduced efficiency | Mechanical integration needs more time in project plan
PCB Development | PCB design should move swiftly into use after fabrication | Boards still require collection, soldering, testing, and soldering. | Hardware stage took longer than expected | PCB development should be split up into smaller milestones in the Gantt chart
Bluetooth Integration | Bluetooth will support system communication during integration | Bluetooth did not function as expected | Delays in integration and additional troubleshooting | Communications systems should be tested earlier and treated as a risk
Overall Delivery | Project tasks will progress mostly in sequence | Delivery became iterative with repeated modifications | Progress was not as linear as planned | Engineering projects need contingency time for delays and interruptions.

## 4. Critical Assessment

Looking back, the project plan was a bit too optimistic in assuming the major parts of the system would work with minimal adjustments necessary. The platform issues showed that more design validation should have taken place before assembly. A fit check or prototype would have reduced later rework.

The PCB process also showed that hardware delivery involves more than producing the design. The boards only became useful after soldering, testing, and troubleshooting, so the original schedule did not reflect the amount of actual work needed to be done.

The Bluetooth issues highlighted the importance of identifying technical issues early. Communication was treated as one part of the system, but once it failed, it made integration more difficult, showing that subsystems can substantially affect overall progress.

The main difference between plan and delivery was therefore not a lack of progress, but an underestimation of how much refinement would be needed before the system would work properly.

## 5. Key Lessons Learned

### 5.1 Early validation saves time later

Designs that appear correct on paper may still fail during assembly. The need to modify the platform and produce multiple versions indicates that dimensions, mounting positions, and chassis compatibility should have been thoroughly checked prior to fabrication.

### 5.2 Mechanical integration should not be underestimated

Repeated removal and refitting of components demonstrated that physical assembly is more time-consuming than it may appear in a project plan. More time should be allocated to fitting, adjustment, and refinement.

### 5.3 PCB work must be planned as a full process

The PCB design is only one part of delivery. The full stage includes fabrication, collection, soldering, testing, and troubleshooting. Future project schedules should show these separate activities rather than treating PCB completion as a single milestone.

### 5.4 Communication systems should be treated as high-risk subsystems

Bluetooth problems showed that communication should be tested earlier, instead of being left until later integration. Wireless systems can introduce delays that affect the wider project.

### 5.5 Iteration is part of engineering

One of the most important lessons from the project is that redesign and rework are not signs of failure. They are normal parts of building a working prototype. Future plans should therefore assume that some level of iteration will be necessary.

### 5.6 Gantt charts should include contingency

The project showed that schedules need to allow for delays, interruptions, and technical setbacks. Adding contingency time would make plans more realistic and easier to manage.

## 6. Conclusion

In conclusion, the line tracking robot project did not progress exactly as originally planned, but this provided valuable insight into the realities of engineering project delivery. The main differences between plan and delivery came from platform redesign, extended PCB implementation work, and Bluetooth integration issues. These challenges showed that successful delivery depends not only on planning, but also on flexibility, validation, and the ability to respond to problems as they arise.

Overall, the project demonstrated that engineering work is rarely a straight path from concept to completion. Instead, it involves repeated checking, refinement, and adaptation. The lessons identified here will help improve future project planning, integration, and risk management.
