ImOutis1669/Line-Following-Robot/(list of files, drawings)

Other design files:
PCB Designs/230090767_AVR_SHIELD_MASTER.pdsprj
PCB Designs/230090767_AVR_SHIELD_SLAVE.pdsprj
PCB Designs/230090767_Motor Driver Connector Board.pdsprj
PCB Designs/230090767_Power Connector Board.pdsprj
PCB Designs/Project Backups/230090767_AVR_SHIELD [20260317, 13-57-43].pdsprj
PCB Designs/Project Backups/230090767_AVR_SHIELD [20260317, 16-06-04].pdsprj
PCB Designs/Project Backups/230090767_AVR_SHIELD_MASTER [20260317, 16-03-55].pdsprj
PCB Designs/Project Backups/230090767_AVR_SHIELD_SLAVE [20260317, 16-09-11].pdsprj
PCB Designs/Project Backups/230090767_AVR_SHIELD_SLAVE [20260317, 16-15-32].pdsprj
Proteus Simulation/Full Line Following/Line Following Simulation.pdsprj
Proteus Simulation/IR Sensor Polling/IR Polling Simulation.pdsprj
Proteus Simulation/Motor Driver Control/DC Motor Control Simulation.pdsprj
